anupamkhandelwal/Self-Balancing-Cycle/README.md

# Self-Balancing-Cycle

The cycle balances itself using a controller which uses the data from an IMU to predict its orientation and rotate an attached mass to balance the center of gravity(COG) of the cycle and henceforth balancing the cycle.

For detailed explanation: [Click here.](https://github.com/anupamkhandelwal/Self-Balancing-Cycle/blob/main/Report.pdf)

Arduino Code: [Click here.](https://github.com/anupamkhandelwal/Self-Balancing-Cycle/blob/main/cycle_main.ino)
